Emute-Lab-Instruments/Myriad/py/cases.png

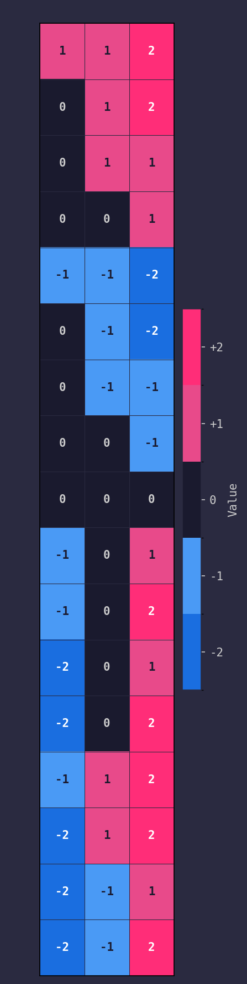
py/cases.png
