Emute-Lab-Instruments/Myriad/hardware/myriad 0.2 panel.stl

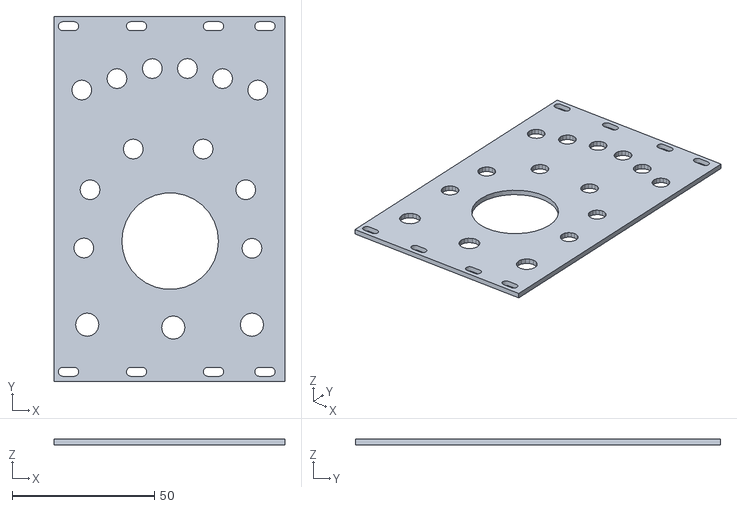
[picture p2: CAD file, 2024-12-16]
hardware/myriad 0.2 panel.stl
81.3 x 128.5 x 2.00
