Emute-Lab-Instruments/Myriad/hardware/panel/myriad2026run/myriad-filled-dxf/myriad-all_layers-filled-pink.dxf

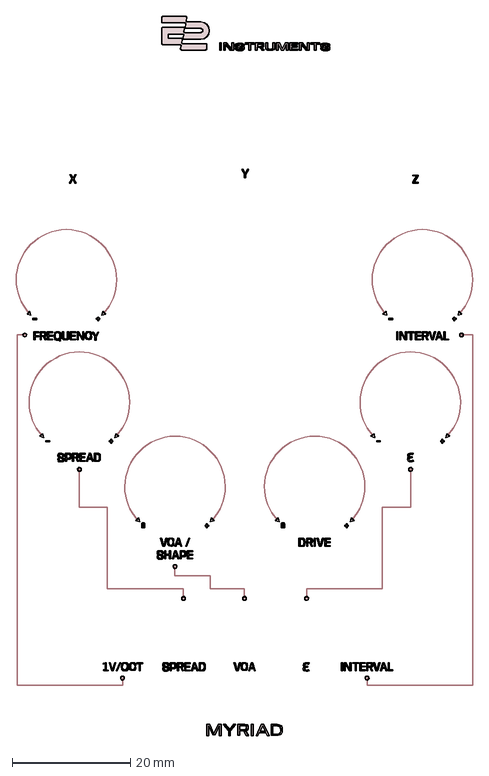
[picture p3: CAD file, 2026-06-30]
hardware/panel/myriad2026run/myriad-filled-dxf/myriad-all_layers-filled-pink.dxf
77.3 x 121.7 mm
