Emute-Lab-Instruments/Myriad/hardware/panel/myriadPanel0_4/myriadPanel0_4.step

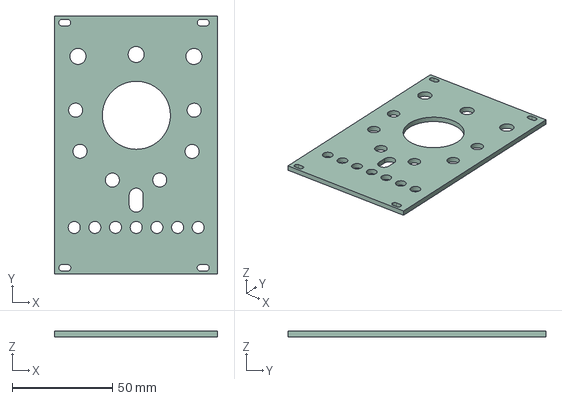
[picture p4: CAD file, 2025-03-19]
hardware/panel/myriadPanel0_4/myriadPanel0_4.step
81.7 x 128.9 x 2.80 mm
