Emute-Lab-Instruments/Myriad/hardware/panel/myriad2026run/myriad-filled-dxf/myriad-all_layers-filled-cnc.dxf

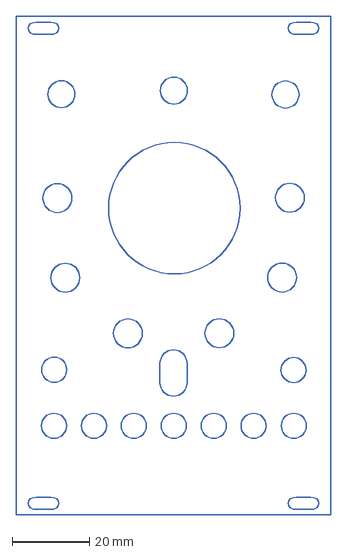
[picture p5: CAD file, 2026-06-30]
hardware/panel/myriad2026run/myriad-filled-dxf/myriad-all_layers-filled-cnc.dxf
81.3 x 128.9 mm
