Emute-Lab-Instruments/Myriad/hardware/spacers.stl

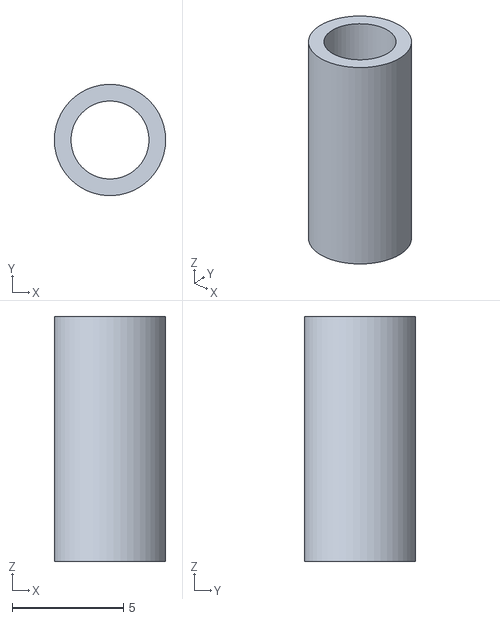
[picture p6: CAD file, 2024-10-05]
hardware/spacers.stl
5.00 x 4.99 x 11.0
