Emute-Lab-Instruments/Myriad/hardware/myriad panel.stl

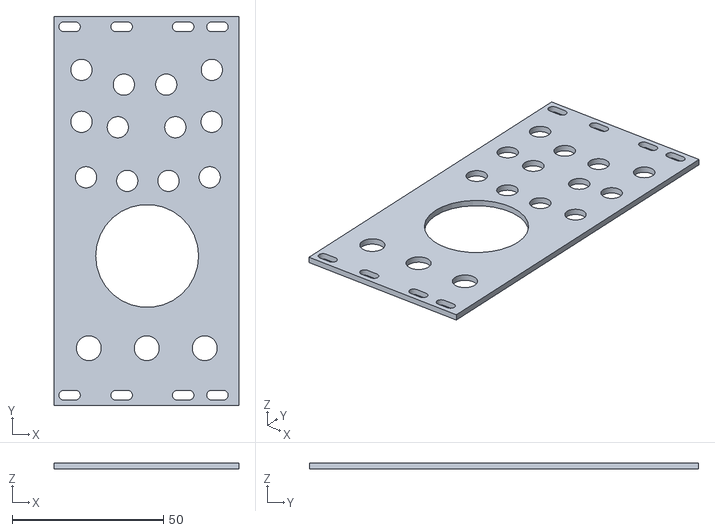
[picture p7: CAD file, 2024-10-05]
hardware/myriad panel.stl
61.0 x 128.5 x 2.00
