Emute-Lab-Instruments/Myriad/hardware/panel/myriad2026run/myriad-filled-dxf/myriad-all_layers-filled-white.dxf

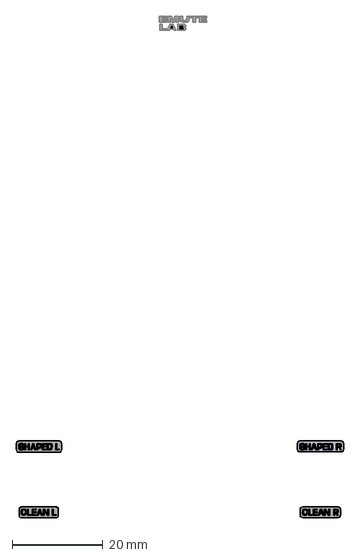
[picture p8: CAD file, 2026-06-30]
hardware/panel/myriad2026run/myriad-filled-dxf/myriad-all_layers-filled-white.dxf
72.0 x 110.3 mm
