Emute-Lab-Instruments/Myriad/hardware/spacers.scad

$fn=50;
difference() {
    cylinder(11, d=5);
    cylinder(13, d=3.5);
    
}
