Emute-Lab-Instruments/Myriad/(list of files, cad)

Other CAD files:
hardware/panel/myriad2026run/fromPosin/myriad-all_layers.dwg
hardware/panel/myriad2026run/fromPosin/myriad-all_layers-filled-cnc.dwg
