Emute-Lab-Instruments/Myriad/calibration/py/adc_calibration.png

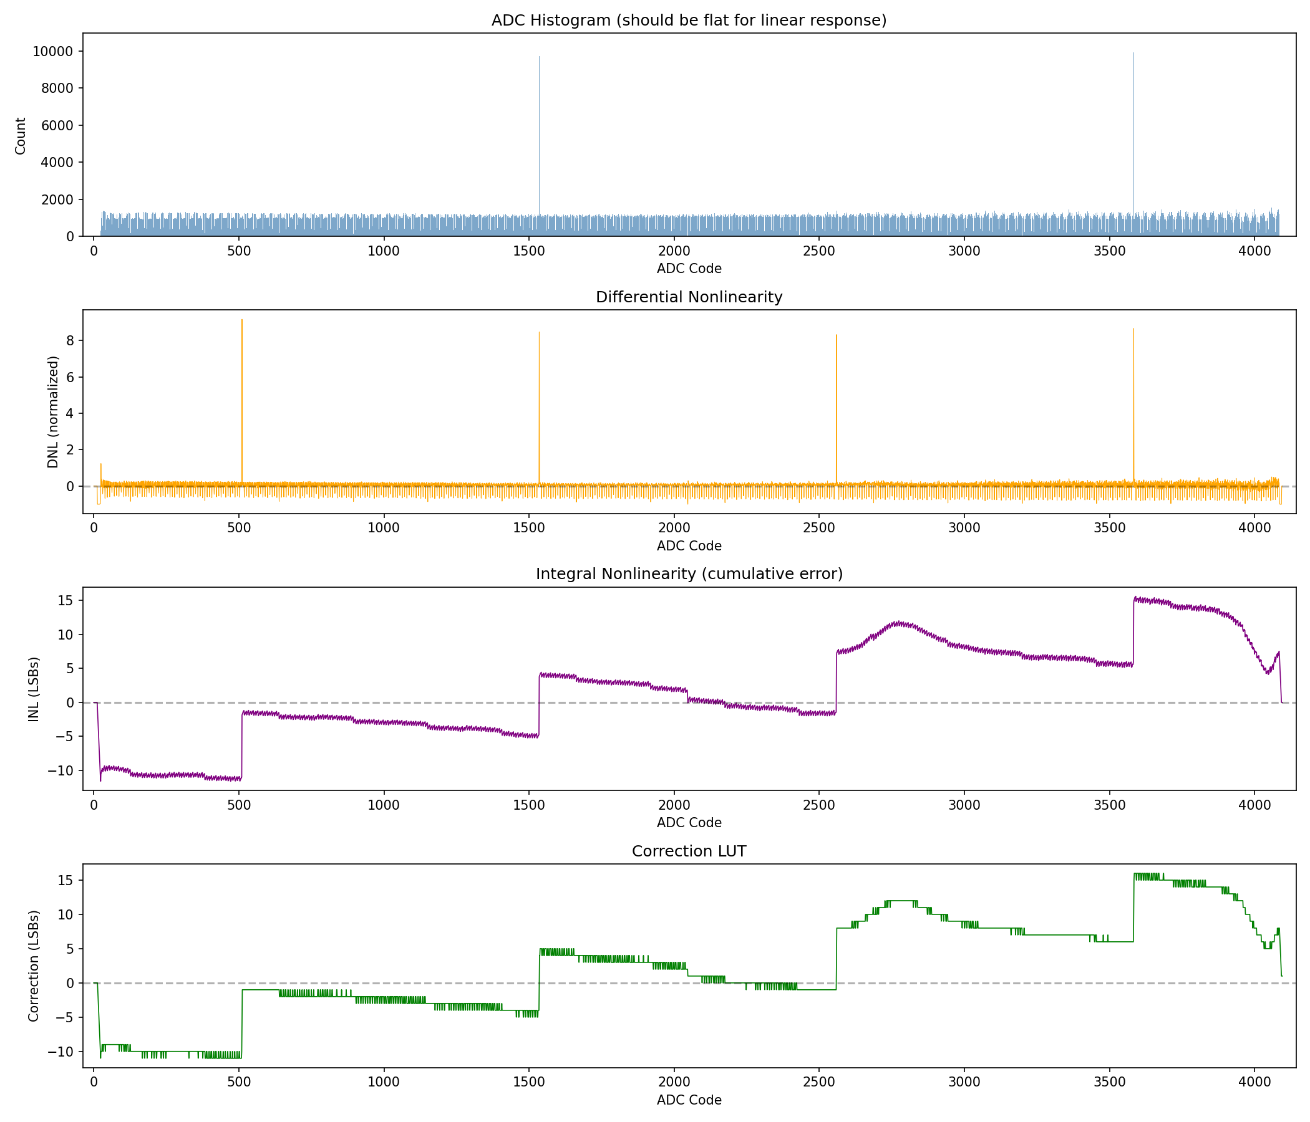
calibration/py/adc_calibration.png
