Emute-Lab-Instruments/Myriad/(threads)

Thread 6 (2025-06-06):

alternatave dma config

chriskiefer, 2025-06-06:
use double buffered ping-pong/chaining?

chriskiefer, 2025-06-06:
actually this doesn't work with interrupts

Closed 2025-06-06.

Thread 17 (2025-07-15):

reset sigma delta oscillators on switch

chriskiefer, 2025-07-15:

Closed 2025-07-18.

Thread 18 (2025-07-18):

zero screen RAM on startup

chriskiefer, 2025-07-18:
prevent noise showing when you switch on the module

Closed 2025-07-23.

Thread 23 (2025-07-23):

encoders should ignore  change when pressed and shortly after

chriskiefer, 2025-07-23:

Thread 26 (2025-07-26):

strategy for saving state

chriskiefer, 2025-07-26:
should we save state?  i.e. restore the last combo of oscillator models on startup?

Writing on every change will quickly eat thru the 100k rewrites spec of the flash memory.  Options:

[1] Run a function every minute (?), and save if there have been changes.  So might make 60 saves per hour,  wears out memory after (1700 hours) 70ish days of use

[2] Manual save - maybe hold down an encoder switch, or add an admin menu. left encoder is unused in oscillator mode

[3] don't save, it's quick anyway to dial in combo, and saving adds complexity. Does it really matter to boot up in previous combo?  Actually maybe yes if you have e.g. a live setup that needs to work the same every time?

stevemuio, 2025-07-26:
> should we save state? i.e. restore the last combo of oscillator models on startup?
>

yes saving is useful as you point out at the end.   maybe a number of presets?

> Writing on every change will quickly eat thru the 100k rewrites spec of the flash memory.

Using a file system like littleFS can help I think it manages wear rather than rewriting over the same sector each time. It also makes reading and writing multiple settings easier into smaller files.

Options:
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

chriskiefer, 2025-07-27:
good to know that littlefs does wear levelling. in which case it will take a long time to use 14mb of flash for just a few bytes of data.  TODO:  look into littlefs config to maximise wear levelling.

Thread 43 (2025-08-31):

concurreny issue when switching screen mode

chriskiefer, 2025-08-31:

Thread 44 (2025-08-31):

sometimes osc model 8 goes silent or glitches when you switch

chriskiefer, 2025-08-31:

chriskiefer, 2025-08-31:
this model isn't actually that interesting, just changes pitch

Closed 2025-08-31.

Thread 45 (2025-08-31):

glitch switching from noise model to p100, but doesn't happen if switching from 8 expdec

chriskiefer, 2025-08-31:

chriskiefer, 2025-08-31:
fixed, loopLength didn't match the length of the template so it was reading old fixed values from buffer memory

Closed 2025-08-31.

Thread 46 (2025-09-01):

modulation should reset when switching metamods

chriskiefer, 2025-09-01:

chriskiefer, 2025-09-03:
actually this probably wasn't a bug - could have been hearing something else as the modulation should reset

Closed 2025-09-03.

Thread 47 (2025-09-01):

make sure pitch doesn't go below 20hz - can crash osc model

chriskiefer, 2025-09-01:
