Emute-Lab-Instruments/Myriad/hardware/myriad_print.pdf

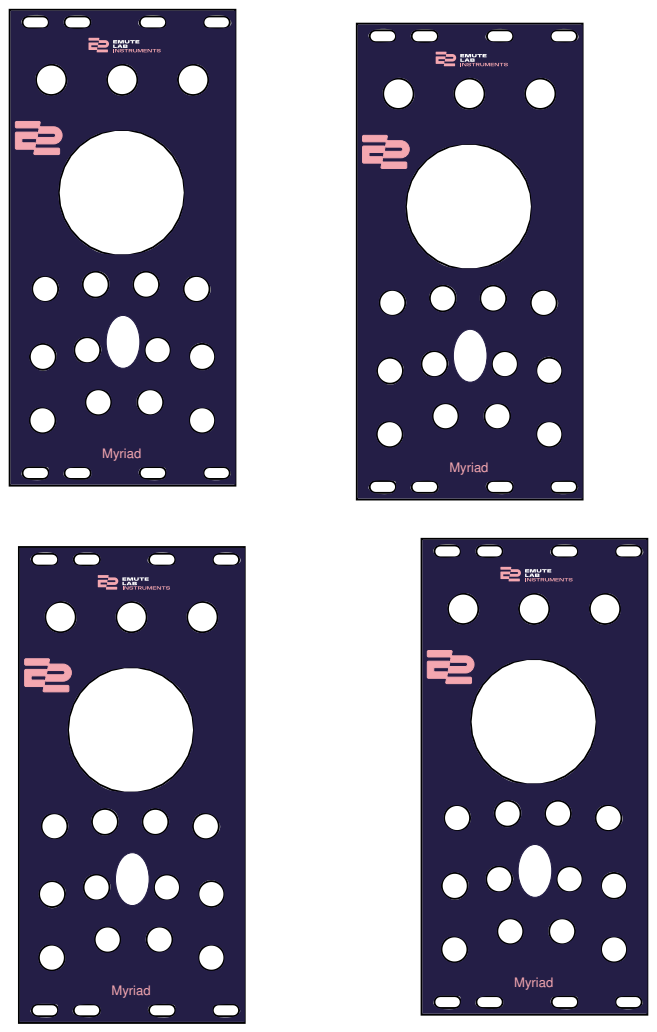
[picture p10: page 1]
Myriad
