Emute-Lab-Instruments/Myriad/arduino_libmyriad/myriad_pins.h

#pragma once

#define LED_PIN 22
#define CALIBRATE_BUTTON 0 //connected to myriad A


//core A1
#define OSC7_PIN 5 //L
#define OSC8_PIN 6 //L
#define OSC9_PIN 10 //R

//core B0
#define OSC1_PIN 2 //R
#define OSC2_PIN 16 //L
#define OSC3_PIN 5 //R
#define OSC1_PIN_DUP 7  //not used

//core B1
#define OSC4_PIN 6 //R
#define OSC5_PIN 17 //L
#define OSC6_PIN 8 // L
