Emute-Lab-Instruments/Myriad/pins.h

#pragma once

#define LED_PIN 22
#define OSC1_PIN 7
#define OSC2_PIN 8
#define OSC3_PIN 9
#define OSC4_PIN 10
#define OSC5_PIN 11
#define OSC6_PIN 12
