Emute-Lab-Instruments/Myriad/Myriad_B/Myriad_B.ino

#include "myriad_pins.h"
#include "hardware/sync.h"
#include "pios/pio_sq.h"
#include "pios/pio_pulse.h"
#include "pios/pio_expdec.h"
#include "pios/pio_bitbybit.h"
#include "smBitStreamOsc.h"
#include "myriad_messages.h"
#include "SLIP.h"
#include "oscillatorModels.hpp"
#include "bitstreams.hpp"

#include <memory>
#include "octaves.hpp"
#include "clockfreq.h"
#include "streamMessaging.hpp"
#include "fixedpoint.hpp"
#include "perf.hpp"

using namespace FixedPoint;
using WvlenFPType = Fixed<20,11>;

#define RUNCORE0_OSCS
#define RUNCORE1_OSCS

bool core1_separate_stack = true;
#define CORE0_FAST_MEM __scratch_x("myriad")
#define CORE1_FAST_MEM __scratch_y("myriad")

#define DMACH_CORE0_OSC0 0
#define DMACH_CORE0_OSC1 2
#define DMACH_CORE0_OSC2 4
#define DMACH_CORE1_OSC0 1
#define DMACH_CORE1_OSC1 3
#define DMACH_CORE1_OSC2 5
#define DMACH_SERIAL_RX_A 6
#define DMACH_SERIAL_RX_B 7


// oscModelPtr FAST_MEM currOscModelBank0;
// oscModelPtr FAST_MEM currOscModelBank1;

std::array<oscModelPtr, 3> FAST_MEM currOscModels0;
std::array<oscModelPtr, 3> FAST_MEM currOscModels1;
std::array<std::array<oscModelPtr, 3>, N_OSCILLATOR_MODELS> allOscModels0;
std::array<std::array<oscModelPtr, 3>, N_OSCILLATOR_MODELS> allOscModels1;

static sawOscillatorModel           sawModels0[3],          sawModels1[3];
static expPulseSDOscillatorModel    expPulseSDModels0[3],   expPulseSDModels1[3];
static sharkTeethSDOscillatorModel  sharkTeethSDModels0[3], sharkTeethSDModels1[3];
static pulsePWOscillatorModel       pulsePWModels0[3],      pulsePWModels1[3];
static expPulse2SDOscillatorModel   expPulse2SDModels0[3],  expPulse2SDModels1[3];
static triOscillatorModel           triModels0[3],          triModels1[3];
static triTeethOscillatorModel      triTeethModels0[3],     triTeethModels1[3];
static parasineSDOscillatorModel    parasineSDModels0[3],   parasineSDModels1[3];
static formantSDOscillatorModel     formantSDModels0[3],    formantSDModels1[3];
static bellSDOscillatorModel        bellSDModels0[3],       bellSDModels1[3];
static noiseOscillatorModelSD       noiseSDModels0[3],      noiseSDModels1[3];
static whiteNoiseOscillatorModel    whiteNoiseModels0[3],   whiteNoiseModels1[3];
static silentOscillatorModel        silentModels0[3],       silentModels1[3];

static spin_lock_t FAST_MEM *calcOscsSpinlock0;
static spin_lock_t FAST_MEM *calcOscsSpinlock1;



volatile bool FAST_MEM waitingForFirstFrequency0=true;
volatile bool FAST_MEM oscsStartedAfterFirstFrequency0=false;
volatile bool FAST_MEM waitingForFirstFrequency1=true;
volatile bool FAST_MEM oscsStartedAfterFirstFrequency1=false;

// Track current bank types to prevent redundant changes
volatile size_t FAST_MEM currentBank0Type = 0;
volatile size_t FAST_MEM currentBank1Type = 0;
volatile size_t FAST_MEM requestedBank0 = 0;
volatile size_t FAST_MEM requestedBank1 = 0;

enum bankChangeStages { BANK_IDLE, BANK_FADING };
bankChangeStages FAST_MEM bankChangeStage0 = BANK_IDLE;
bankChangeStages FAST_MEM bankChangeStage1 = BANK_IDLE;
volatile bool FAST_MEM changeBankFlag0 = false;
volatile bool FAST_MEM changeBankFlag1 = false;



DEFINE_TIMING_SWAPBUFFERS(0, __scratch_x("swap"))
DEFINE_TIMING_SWAPBUFFERS(1, __scratch_x("swap"))
DEFINE_TIMING_SWAPBUFFERS(2, __scratch_x("swap"))
DEFINE_TIMING_SWAPBUFFERS(3, __scratch_y("swap"))
DEFINE_TIMING_SWAPBUFFERS(4, __scratch_y("swap"))
DEFINE_TIMING_SWAPBUFFERS(5, __scratch_y("swap"))


uint32_t CORE0_FAST_MEM smOsc0_dma_chan;
uint32_t CORE0_FAST_MEM smOsc0_dma_chan_bit;

uint32_t CORE0_FAST_MEM smOsc1_dma_chan;
uint32_t CORE0_FAST_MEM smOsc1_dma_chan_bit;

uint32_t CORE0_FAST_MEM smOsc2_dma_chan;
uint32_t CORE0_FAST_MEM smOsc2_dma_chan_bit;

bool FAST_MEM bufSent0 = false;
bool FAST_MEM bufSent1 = false;
bool FAST_MEM bufSent2 = false;
bool FAST_MEM bufSent3 = false;
bool FAST_MEM bufSent4 = false;
bool FAST_MEM bufSent5 = false;



/////////////////////////////////   IRQ 000000000000000000000000000000000000
void __isr dma_irh() {
  //TEST
  // Serial.println("dma");
  uint32_t triggered_channels = dma_hw->ints0;
  if (triggered_channels & smOsc0_dma_chan_bit) {
    dma_hw->ints0 = smOsc0_dma_chan_bit;  
    dma_hw->ch[smOsc0_dma_chan].al3_read_addr_trig = nextTimingBuffer0;
    bufSent0 = true;
  }
  else
  if (triggered_channels & smOsc1_dma_chan_bit) {
    dma_hw->ints0 = smOsc1_dma_chan_bit;
    dma_hw->ch[smOsc1_dma_chan].al3_read_addr_trig = nextTimingBuffer1;
    bufSent1 = true;
  }
  else
  if (triggered_channels & smOsc2_dma_chan_bit) {
    dma_hw->ints0 = smOsc2_dma_chan_bit;
    dma_hw->ch[smOsc2_dma_chan].al3_read_addr_trig = nextTimingBuffer2;
    bufSent2 = true;
  }
}
smBitStreamOsc FAST_MEM smOsc0;
smBitStreamOsc FAST_MEM smOsc1;
smBitStreamOsc FAST_MEM smOsc2;


uint32_t CORE1_FAST_MEM smOsc3_dma_chan;
uint32_t CORE1_FAST_MEM smOsc3_dma_chan_bit;
uint32_t CORE1_FAST_MEM smOsc4_dma_chan;
uint32_t CORE1_FAST_MEM smOsc4_dma_chan_bit;
uint32_t CORE1_FAST_MEM smOsc5_dma_chan;
uint32_t CORE1_FAST_MEM smOsc5_dma_chan_bit;

bool FAST_MEM oscsRunning0 = false;
bool FAST_MEM oscsRunning1 = false;

Fixed<16,16> FAST_MEM epsilon_fixed(0);

PERF_DECLARE(SERIALRX);
PERF_DECLARE(CALCOSCS0);
PERF_DECLARE(CALCOSCS1);




/////////////////////////////////   IRQ 11111111111111111111111111111
void __not_in_flash_func(dma_irh1)() {
  uint32_t triggered_channels = dma_hw->ints1;
  if (triggered_channels & smOsc3_dma_chan_bit) {
    dma_hw->ints1 = smOsc3_dma_chan_bit;  
    dma_hw->ch[smOsc3_dma_chan].al3_read_addr_trig = nextTimingBuffer3;
    bufSent3 = true;
  }
  else
  if (triggered_channels & smOsc4_dma_chan_bit) {
  //   // Channel 0 triggered, handle it
    dma_hw->ints1 = smOsc4_dma_chan_bit;
    dma_hw->ch[smOsc4_dma_chan].al3_read_addr_trig = nextTimingBuffer4;
    bufSent4 = true;
  }
  else
  if (triggered_channels & smOsc5_dma_chan_bit) {
    dma_hw->ints1 = smOsc5_dma_chan_bit;
    dma_hw->ch[smOsc5_dma_chan].al3_read_addr_trig = nextTimingBuffer5;
    bufSent5 = true;
  }
}


smBitStreamOsc FAST_MEM smOsc3;
smBitStreamOsc FAST_MEM smOsc4;
smBitStreamOsc FAST_MEM smOsc5;



enum SPISTATES {WAITFOREND, ENDORBYTES, READBYTES};
static SPISTATES  __not_in_flash("mydata") spiState = SPISTATES::WAITFOREND;
static int __not_in_flash("mydata") spiIdx=0;

int oscBankChange=-1;

void restart_sm(PIO pio, uint sm) {
  // Reset the state machine program counter to zero
  // pio_sm_exec(pio, sm, pio_encode_jmp(0));
  
  // Alternatively, you can use the RESTART flag directly:
  pio->ctrl = (1u << (PIO_CTRL_SM_RESTART_LSB + sm));
}

void assignOscModels0(size_t modelIdx) {
  for (size_t i = 0; i < currOscModels0.size(); i++) {
    currOscModels0[i] = allOscModels0[modelIdx][i];
  }
}
void assignOscModels1(size_t modelIdx) {
  for (size_t i = 0; i < currOscModels1.size(); i++) {
    currOscModels1[i] = allOscModels1[modelIdx][i];
  }
}

void __force_inline calculateOscBuffers0() {
  if ((currOscModels0[0]->updateBufferInSyncWithDMA && bufSent0) || (!currOscModels0[0]->updateBufferInSyncWithDMA && currOscModels0[0]->newFreq)) {
    currOscModels0[0]->newFreq = false;
    updateTimingBuffer(nextTimingBuffer0, timing_swapbuffer_0_A, timing_swapbuffer_0_B, currOscModels0[0]);
    bufSent0 = false;
  }
  if ((currOscModels0[1]->updateBufferInSyncWithDMA && bufSent1) || (!currOscModels0[1]->updateBufferInSyncWithDMA && currOscModels0[1]->newFreq)) {
    currOscModels0[1]->newFreq = false;
    updateTimingBuffer(nextTimingBuffer1, timing_swapbuffer_1_A, timing_swapbuffer_1_B, currOscModels0[1]);
    bufSent1 = false;
  }
  if ((currOscModels0[2]->updateBufferInSyncWithDMA && bufSent2) || (!currOscModels0[2]->updateBufferInSyncWithDMA && currOscModels0[2]->newFreq)) {
    currOscModels0[2]->newFreq = false;
    updateTimingBuffer(nextTimingBuffer2, timing_swapbuffer_2_A, timing_swapbuffer_2_B, currOscModels0[2]);
    bufSent2 = false;
  }
}

void __force_inline calculateOscBuffers1() {
  if ((currOscModels1[0]->updateBufferInSyncWithDMA && bufSent3) || (!currOscModels1[0]->updateBufferInSyncWithDMA && currOscModels1[0]->newFreq)) {
    currOscModels1[0]->newFreq = false;
    updateTimingBuffer(nextTimingBuffer3, timing_swapbuffer_3_A, timing_swapbuffer_3_B, currOscModels1[0]);
    bufSent3 = false;
  }
  if ((currOscModels1[1]->updateBufferInSyncWithDMA && bufSent4) || (!currOscModels1[1]->updateBufferInSyncWithDMA && currOscModels1[1]->newFreq)) {
    currOscModels1[1]->newFreq = false;
    updateTimingBuffer(nextTimingBuffer4, timing_swapbuffer_4_A, timing_swapbuffer_4_B, currOscModels1[1]);
    bufSent4 = false;
  }
  if ((currOscModels1[2]->updateBufferInSyncWithDMA && bufSent5) || (!currOscModels1[2]->updateBufferInSyncWithDMA && currOscModels1[2]->newFreq)) {
    currOscModels1[2]->newFreq = false;
    updateTimingBuffer(nextTimingBuffer5, timing_swapbuffer_5_A, timing_swapbuffer_5_B, currOscModels1[2]);
    bufSent5 = false;
  }
}


WvlenFPType FAST_MEM detuneFixed(0);
Q16_16 FAST_MEM metaModWavelenMul3(1);
Q16_16 FAST_MEM metaModWavelenMul4(1);
Q16_16 FAST_MEM metaModWavelenMul5(1);
Q16_16 FAST_MEM metaModWavelenMul6(1);
Q16_16 FAST_MEM metaModWavelenMul7(1);
Q16_16 FAST_MEM metaModWavelenMul8(1);

size_t FAST_MEM octaveIdx = 9;

bool FAST_MEM newFrequenciesReady0 = false;
bool FAST_MEM newFrequenciesReady1 = false;

// float new_wavelen0 = 10000;
WvlenFPType new_wavelen2_fixed;


// static uint8_t __scratch_x("mydata") slipBuffer[64];
bool FAST_MEM newCtrlReady = false;


void startOscBankA() {

  uint programOffset = currOscModels0[0]->loadProg(pio0);


  pio_sm_config baseConfig = currOscModels0[0]->getBaseConfig(programOffset);
  const size_t modelClockDiv = currOscModels0[0]->getClockDiv();

  smOsc0_dma_chan = smOsc0.init(pio0, 0, OSC1_PIN, programOffset, baseConfig, nextTimingBuffer0, dma_irh, modelClockDiv, currOscModels0[0]->loopLength, DMA_IRQ_0, DMACH_CORE0_OSC0);
  if (smOsc0_dma_chan < 0) {
    Serial.println("dma chan allocation error");
  }
  smOsc0_dma_chan_bit = 1u << smOsc0_dma_chan;
  smOsc0.go();

  smOsc1_dma_chan = smOsc1.init(pio0, 1, OSC2_PIN, programOffset, baseConfig, nextTimingBuffer1, dma_irh, modelClockDiv, currOscModels0[1]->loopLength, DMA_IRQ_0,DMACH_CORE0_OSC1);
  smOsc1_dma_chan_bit = 1u << smOsc1_dma_chan;
  smOsc1.go();

  smOsc2_dma_chan = smOsc2.init(pio0, 2, OSC3_PIN, programOffset, baseConfig, nextTimingBuffer2, dma_irh, modelClockDiv, currOscModels0[2]->loopLength, DMA_IRQ_0, DMACH_CORE0_OSC2);
  smOsc2_dma_chan_bit = 1u << smOsc2_dma_chan;
  smOsc2.go();

  oscsRunning0 = true;
}

void stopOscBankA() {

  oscsRunning0 = false;

  smOsc0.stop();
  smOsc1.stop();
  smOsc2.stop();

  currOscModels0[0]->unloadProg(pio0);

  // Clear the buffers explicitly
  memset(timing_swapbuffer_0_A, 0, sizeof(timing_swapbuffer_0_A));
  memset(timing_swapbuffer_0_B, 0, sizeof(timing_swapbuffer_0_B));
  memset(timing_swapbuffer_1_A, 0, sizeof(timing_swapbuffer_1_A));
  memset(timing_swapbuffer_1_B, 0, sizeof(timing_swapbuffer_1_B));
  memset(timing_swapbuffer_2_A, 0, sizeof(timing_swapbuffer_2_A));
  memset(timing_swapbuffer_2_B, 0, sizeof(timing_swapbuffer_2_B));

  // Reset buffer pointers to A buffers
  nextTimingBuffer0 = (io_rw_32)timing_swapbuffer_0_A;
  nextTimingBuffer1 = (io_rw_32)timing_swapbuffer_1_A;
  nextTimingBuffer2 = (io_rw_32)timing_swapbuffer_2_A;

  bufSent0 = false;
  bufSent1 = false;
  bufSent2 = false;

}

void startOscBankB() {


  // Don't clear entire PIO - this would destroy the RX program
  // The oscillator loadProg() will add its program without clearing others
  // pio_clear_instruction_memory(pio1);

  uint programOffset = currOscModels1[0]->loadProg(pio1);
  pio_sm_config baseConfig = currOscModels1[0]->getBaseConfig(programOffset);

  const size_t modelClockDiv = currOscModels1[0]->getClockDiv();

  // Monitor PIO program placement
  // Check how much PIO memory is used (32 instructions max)

  smOsc3_dma_chan = smOsc3.init(pio1, 0, OSC4_PIN, programOffset, baseConfig, nextTimingBuffer3, dma_irh1, modelClockDiv, currOscModels1[0]->loopLength, DMA_IRQ_1, DMACH_CORE1_OSC0);
  smOsc3_dma_chan_bit = 1u << smOsc3_dma_chan;
  smOsc3.go();

  smOsc4_dma_chan = smOsc4.init(pio1, 1, OSC5_PIN, programOffset, baseConfig, nextTimingBuffer4, dma_irh1, modelClockDiv, currOscModels1[1]->loopLength, DMA_IRQ_1, DMACH_CORE1_OSC1);
  smOsc4_dma_chan_bit = 1u << smOsc4_dma_chan;
  smOsc4.go();

  smOsc5_dma_chan = smOsc5.init(pio1, 2, OSC6_PIN, programOffset, baseConfig, nextTimingBuffer5, dma_irh1, modelClockDiv, currOscModels1[2]->loopLength, DMA_IRQ_1, DMACH_CORE1_OSC2);
  smOsc5_dma_chan_bit = 1u << smOsc5_dma_chan;
  smOsc5.go();
  oscsRunning1 = true;


}

void stopOscBankB() {
  oscsRunning1 = false;

  smOsc3.stop();
  smOsc4.stop();
  smOsc5.stop();

  currOscModels1[0]->unloadProg(pio1);


  memset(timing_swapbuffer_3_A, 0, sizeof(timing_swapbuffer_3_A));
  memset(timing_swapbuffer_3_B, 0, sizeof(timing_swapbuffer_3_B));
  memset(timing_swapbuffer_4_A, 0, sizeof(timing_swapbuffer_4_A));
  memset(timing_swapbuffer_4_B, 0, sizeof(timing_swapbuffer_4_B));
  memset(timing_swapbuffer_5_A, 0, sizeof(timing_swapbuffer_5_A));
  memset(timing_swapbuffer_5_B, 0, sizeof(timing_swapbuffer_5_B));
  
  // Reset buffer pointers to A buffers
  nextTimingBuffer3 = (io_rw_32)timing_swapbuffer_3_A;
  nextTimingBuffer4 = (io_rw_32)timing_swapbuffer_4_A;
  nextTimingBuffer5 = (io_rw_32)timing_swapbuffer_5_A;  

  bufSent3 = false;
  bufSent4 = false;
  bufSent5 = false;

}

__force_inline void __not_in_flash_func(processSerialMessage)(streamMessaging::msgpacket &msg) {
  switch(msg.msgType) {
    case streamMessaging::messageTypes::WAVELEN0:
    {
      
      // uint32_t save = spin_lock_blocking(calcOscsSpinlock0);  
      // new_wavelen0 = msg.value.floatValue;
      WvlenFPType new_wavelen0_fixed = WvlenFPType::from_raw(msg.value.intValue);
      new_wavelen2_fixed = new_wavelen0_fixed - detuneFixed - detuneFixed;
      newFrequenciesReady0 = true;
      newFrequenciesReady1 = true;
      waitingForFirstFrequency0 = false;
      waitingForFirstFrequency1 = false;
      break;
    }
    case streamMessaging::messageTypes::DETUNE:
    {
      detuneFixed = WvlenFPType::from_raw(msg.value.intValue);
      break;
    }     
    case streamMessaging::messageTypes::METAMOD3:
    {
      metaModWavelenMul3 = Q16_16::from_raw(msg.value.intValue);
      break;
    }
    case streamMessaging::messageTypes::METAMOD4:
    {
      metaModWavelenMul4 = Q16_16::from_raw(msg.value.intValue);
      break;
    }
    case streamMessaging::messageTypes::METAMOD5:
    {
      metaModWavelenMul5 = Q16_16::from_raw(msg.value.intValue);
      break;
    }
    case streamMessaging::messageTypes::METAMOD6:
    {
      uint32_t save1 = spin_lock_blocking(calcOscsSpinlock1);  
      metaModWavelenMul6 = Q16_16::from_raw(msg.value.intValue);
      spin_unlock(calcOscsSpinlock1, save1);
      break;
    }
    case streamMessaging::messageTypes::METAMOD7:
    {
      uint32_t save1 = spin_lock_blocking(calcOscsSpinlock1);  
      metaModWavelenMul7 = Q16_16::from_raw(msg.value.intValue);
      spin_unlock(calcOscsSpinlock1, save1);
      break;
    }
    case streamMessaging::messageTypes::METAMOD8:
    {
      uint32_t save1 = spin_lock_blocking(calcOscsSpinlock1);  
      metaModWavelenMul8 = Q16_16::from_raw(msg.value.intValue);
      spin_unlock(calcOscsSpinlock1, save1);
      break;
    }
    case streamMessaging::messageTypes::OCTSPREAD:
    {
      octaveIdx = msg.value.uintValue;
      if (octaveIdx > numOctaveShifts-1) octaveIdx = numOctaveShifts-1;
      currentOctaveShifts = (int8_t *)octaveTableShift[octaveIdx];
      break;
    }
    case streamMessaging::messageTypes::CTRL0:
    {
      epsilon_fixed = Q16_16::from_raw(msg.value.intValue);
      newCtrlReady = true;

      currOscModels0[0]->ctrl(epsilon_fixed);
      currOscModels0[1]->ctrl(epsilon_fixed);
      currOscModels0[2]->ctrl(epsilon_fixed);

      break;
    }
    case streamMessaging::messageTypes::BANK0:
    {
      size_t bank = msg.value.uintValue;
      size_t targetBank0 = changeBankFlag0 ? requestedBank0 : currentBank0Type;
      // Serial.printf("bank0 change %d\n", bank);
      if (bank != targetBank0) {
        requestedBank0 = bank;
        changeBankFlag0 = true;
      }
    }
    break;
    case streamMessaging::messageTypes::BANK1:
    {
      size_t bank = msg.value.uintValue;
      uint32_t save = spin_lock_blocking(calcOscsSpinlock1);
      size_t targetBank1 = changeBankFlag1 ? requestedBank1 : currentBank1Type;
      if (bank != targetBank1) {
        requestedBank1 = bank;
        changeBankFlag1 = true;
      }
      spin_unlock(calcOscsSpinlock1, save);
    }
    break;
    default:
      break;
  }
}  



const size_t oscStartDelay = 200;

void setup() {
  //show on board LED
  pinMode(LED_PIN, OUTPUT);
  digitalWrite(LED_PIN, 0);

  calcOscsSpinlock0 = spin_lock_init(spin_lock_claim_unused(true));

  for (size_t i = 0; i < 3; i++) {
    allOscModels0[0][i]  = &sawModels0[i];
    allOscModels0[1][i]  = &expPulseSDModels0[i];
    allOscModels0[2][i]  = &sharkTeethSDModels0[i];
    allOscModels0[3][i]  = &pulsePWModels0[i];
    allOscModels0[4][i]  = &expPulse2SDModels0[i];
    allOscModels0[5][i]  = &triModels0[i];
    allOscModels0[6][i]  = &triTeethModels0[i];
    allOscModels0[7][i]  = &parasineSDModels0[i];
    allOscModels0[8][i]  = &formantSDModels0[i];
    allOscModels0[9][i]  = &bellSDModels0[i];
    allOscModels0[10][i] = &noiseSDModels0[i];
    allOscModels0[11][i] = &whiteNoiseModels0[i];
    allOscModels0[12][i] = &silentModels0[i];
  }
  assignOscModels0(0);


  Serial.begin();
  // while(!Serial) {}
  pinMode(22,OUTPUT);
  streamMessaging::setupRX(pio0, 22, 12, DMACH_SERIAL_RX_A, DMACH_SERIAL_RX_B);
}

size_t counter=0;
size_t checkevery=20000;
size_t errorCount=0;
size_t totalMessagesReceived=0;

size_t serialts=0;

void __not_in_flash_func(loop)() {
  digitalWrite(22,0);

  streamMessaging::msgpacket* msg;
  streamMessaging::RxStatus status = streamMessaging::receiveWithDMA(&msg);

  if (status != streamMessaging::RxStatus::NO_MESSAGE) {
      if (status == streamMessaging::RxStatus::MESSAGE_OK) {
          totalMessagesReceived++;
          digitalWrite(22,1);
          PERF_BEGIN(SERIALRX);
          processSerialMessage(*msg);
          PERF_END(SERIALRX);
      } else {
          errorCount++;
      }
      // if (counter++ == checkevery) {
      //     Serial.printf("%d messages received, %d errors, %d total\n", checkevery, errorCount,totalMessagesReceived);
      //     counter=0;
      //     errorCount=0;
      // }
  }
  if (waitingForFirstFrequency0 == false && oscsStartedAfterFirstFrequency0 == false) {

    startOscBankA();
    oscsStartedAfterFirstFrequency0 = true;
  }
  if (oscsRunning0) {
    if (newFrequenciesReady0) {
      WvlenFPType new_wavelen3_fixed = (new_wavelen2_fixed - detuneFixed);
      WvlenFPType new_wavelen4_fixed = (new_wavelen3_fixed - detuneFixed);
      WvlenFPType new_wavelen5_fixed = (new_wavelen4_fixed - detuneFixed);

      new_wavelen3_fixed = new_wavelen3_fixed.mulWith(metaModWavelenMul3);
      new_wavelen4_fixed = new_wavelen4_fixed.mulWith(metaModWavelenMul4);
      new_wavelen5_fixed = new_wavelen5_fixed.mulWith(metaModWavelenMul5);

      // guard against negative wavelen (heavy detune at low pitch) wrapping to huge size_t
      if (new_wavelen3_fixed < minWavelenFP) new_wavelen3_fixed = minWavelenFP;
      if (new_wavelen4_fixed < minWavelenFP) new_wavelen4_fixed = minWavelenFP;
      if (new_wavelen5_fixed < minWavelenFP) new_wavelen5_fixed = minWavelenFP;

      new_wavelen3_fixed = currentOctaveShifts[1] > 0 ? new_wavelen3_fixed >> currentOctaveShifts[1] : new_wavelen3_fixed.safeShiftLeft(-currentOctaveShifts[1]);
      new_wavelen4_fixed = currentOctaveShifts[1] > 0 ? new_wavelen4_fixed >> currentOctaveShifts[1] : new_wavelen4_fixed.safeShiftLeft(-currentOctaveShifts[1]);
      new_wavelen5_fixed = currentOctaveShifts[1] > 0 ? new_wavelen5_fixed >> currentOctaveShifts[1] : new_wavelen5_fixed.safeShiftLeft(-currentOctaveShifts[1]);

      currOscModels0[0]->setWavelen(new_wavelen3_fixed.to_int());
      currOscModels0[1]->setWavelen(new_wavelen4_fixed.to_int());
      currOscModels0[2]->setWavelen(new_wavelen5_fixed.to_int());
      newFrequenciesReady0 = false;
    }
    
    // uint32_t save = spin_lock_blocking(calcOscsSpinlock0);
    PERF_BEGIN(CALCOSCS0);
    calculateOscBuffers0();
    PERF_END(CALCOSCS0);
    // spin_unlock(calcOscsSpinlock0, save);

    if (changeBankFlag0) {
      if (bankChangeStage0 == BANK_IDLE) {
        currOscModels0[0]->startFadeOut();
        currOscModels0[1]->startFadeOut();
        currOscModels0[2]->startFadeOut();
        bankChangeStage0 = BANK_FADING;
      } else if (bankChangeStage0 == BANK_FADING) {
        if (!currOscModels0[0]->isFadingOut()) {
          auto w1 = currOscModels0[0]->getWavelen();
          auto w2 = currOscModels0[1]->getWavelen();
          auto w3 = currOscModels0[2]->getWavelen();

          assignOscModels0(requestedBank0);

          smOsc0.setClockDiv(currOscModels0[0]->getClockDiv());
          smOsc1.setClockDiv(currOscModels0[1]->getClockDiv());
          smOsc2.setClockDiv(currOscModels0[2]->getClockDiv());

          currOscModels0[0]->prepareForFadeIn();
          currOscModels0[1]->prepareForFadeIn();
          currOscModels0[2]->prepareForFadeIn();

          currOscModels0[0]->setWavelen(w1);
          currOscModels0[1]->setWavelen(w2);
          currOscModels0[2]->setWavelen(w3);

          currOscModels0[0]->ctrl(epsilon_fixed);
          currOscModels0[1]->ctrl(epsilon_fixed);
          currOscModels0[2]->ctrl(epsilon_fixed);

          currOscModels0[0]->startFadeIn();
          currOscModels0[1]->startFadeIn();
          currOscModels0[2]->startFadeIn();

          currentBank0Type = requestedBank0;
          bankChangeStage0 = BANK_IDLE;
          changeBankFlag0 = false;
        }
      }
    }
  }

  // auto now = millis();
  // if (now - serialts > 500) {
  //   size_t elapsed = now - serialts;
  //   float msgsPerSec = totalMessagesReceived * 1000.f / elapsed;
  //   Serial.printf("srx: %d us  msgs: %.0f/s  errs: %u  c0: %d us  c1: %d us\n",
  //       PERF_GET_MEAN(SERIALRX),
  //       msgsPerSec,
  //       errorCount,
  //       PERF_GET_MEAN(CALCOSCS0),
  //       PERF_GET_MEAN(CALCOSCS1));
  //   totalMessagesReceived = 0;
  //   errorCount = 0;
  //   serialts=now;
  // }
  // delay(1);
  // __wfi();
}


void setup1() {
  calcOscsSpinlock1 = spin_lock_init(spin_lock_claim_unused(true));

  for (size_t i = 0; i < 3; i++) {
    allOscModels1[0][i]  = &sawModels1[i];
    allOscModels1[1][i]  = &expPulseSDModels1[i];
    allOscModels1[2][i]  = &sharkTeethSDModels1[i];
    allOscModels1[3][i]  = &pulsePWModels1[i];
    allOscModels1[4][i]  = &expPulse2SDModels1[i];
    allOscModels1[5][i]  = &triModels1[i];
    allOscModels1[6][i]  = &triTeethModels1[i];
    allOscModels1[7][i]  = &parasineSDModels1[i];
    allOscModels1[8][i]  = &formantSDModels1[i];
    allOscModels1[9][i]  = &bellSDModels1[i];
    allOscModels1[10][i] = &noiseSDModels1[i];
    allOscModels1[11][i] = &whiteNoiseModels1[i];
    allOscModels1[12][i] = &silentModels1[i];
  }
  assignOscModels1(0);


}

void __not_in_flash_func(loop1)() {
  if (waitingForFirstFrequency1 == false && oscsStartedAfterFirstFrequency1 == false) {
    startOscBankB();
    oscsStartedAfterFirstFrequency1 = true;
  }
  if (oscsRunning1) {
    if (changeBankFlag1) {
      if (bankChangeStage1 == BANK_IDLE) {
        currOscModels1[0]->startFadeOut();
        currOscModels1[1]->startFadeOut();
        currOscModels1[2]->startFadeOut();
        bankChangeStage1 = BANK_FADING;
      } else if (bankChangeStage1 == BANK_FADING) {
        if (!currOscModels1[0]->isFadingOut()) {
          uint32_t save = spin_lock_blocking(calcOscsSpinlock1);
          size_t targetBank = requestedBank1;
          spin_unlock(calcOscsSpinlock1, save);

          auto w1 = currOscModels1[0]->getWavelen();
          auto w2 = currOscModels1[1]->getWavelen();
          auto w3 = currOscModels1[2]->getWavelen();

          assignOscModels1(targetBank);

          smOsc3.setClockDiv(currOscModels1[0]->getClockDiv());
          smOsc4.setClockDiv(currOscModels1[1]->getClockDiv());
          smOsc5.setClockDiv(currOscModels1[2]->getClockDiv());

          currOscModels1[0]->prepareForFadeIn();
          currOscModels1[1]->prepareForFadeIn();
          currOscModels1[2]->prepareForFadeIn();

          currOscModels1[0]->setWavelen(w1);
          currOscModels1[1]->setWavelen(w2);
          currOscModels1[2]->setWavelen(w3);

          currOscModels1[0]->ctrl(epsilon_fixed);
          currOscModels1[1]->ctrl(epsilon_fixed);
          currOscModels1[2]->ctrl(epsilon_fixed);

          currOscModels1[0]->startFadeIn();
          currOscModels1[1]->startFadeIn();
          currOscModels1[2]->startFadeIn();

          save = spin_lock_blocking(calcOscsSpinlock1);
          currentBank1Type = targetBank;
          changeBankFlag1 = false;
          spin_unlock(calcOscsSpinlock1, save);

          bankChangeStage1 = BANK_IDLE;
        }
      }
    }

    if (newCtrlReady) {
      currOscModels1[0]->ctrl(epsilon_fixed);
      currOscModels1[1]->ctrl(epsilon_fixed);
      currOscModels1[2]->ctrl(epsilon_fixed);
      newCtrlReady = false;
    }
    if (newFrequenciesReady1) {
      WvlenFPType new_wavelen6_fixed = (new_wavelen2_fixed - detuneFixed - detuneFixed - detuneFixed - detuneFixed );
      WvlenFPType new_wavelen7_fixed = (new_wavelen6_fixed - detuneFixed);
      WvlenFPType new_wavelen8_fixed = (new_wavelen7_fixed - detuneFixed);

      new_wavelen6_fixed = new_wavelen6_fixed.mulWith(metaModWavelenMul6);
      new_wavelen7_fixed = new_wavelen7_fixed.mulWith(metaModWavelenMul7);
      new_wavelen8_fixed = new_wavelen8_fixed.mulWith(metaModWavelenMul8);

      // guard against negative wavelen (heavy detune at low pitch) wrapping to huge size_t
      if (new_wavelen6_fixed < minWavelenFP) new_wavelen6_fixed = minWavelenFP;
      if (new_wavelen7_fixed < minWavelenFP) new_wavelen7_fixed = minWavelenFP;
      if (new_wavelen8_fixed < minWavelenFP) new_wavelen8_fixed = minWavelenFP;

      new_wavelen6_fixed = currentOctaveShifts[2] > 0 ? new_wavelen6_fixed >> currentOctaveShifts[2] : new_wavelen6_fixed.safeShiftLeft(-currentOctaveShifts[2]);
      new_wavelen7_fixed = currentOctaveShifts[2] > 0 ? new_wavelen7_fixed >> currentOctaveShifts[2] : new_wavelen7_fixed.safeShiftLeft(-currentOctaveShifts[2]);
      new_wavelen8_fixed = currentOctaveShifts[2] > 0 ? new_wavelen8_fixed >> currentOctaveShifts[2] : new_wavelen8_fixed.safeShiftLeft(-currentOctaveShifts[2]);

      currOscModels1[0]->setWavelen(new_wavelen6_fixed.to_int());
      currOscModels1[1]->setWavelen(new_wavelen7_fixed.to_int());
      currOscModels1[2]->setWavelen(new_wavelen8_fixed.to_int());
      newFrequenciesReady1 = false;
    }
    // uint32_t save = spin_lock_blocking(calcOscsSpinlock1);
    PERF_BEGIN(CALCOSCS1);
    calculateOscBuffers1();
    PERF_END(CALCOSCS1);
    // spin_unlock(calcOscsSpinlock1, save);

  }
}
