Emute-Lab-Instruments/Myriad/Myriad_A/ADCCalDefault.hpp

#ifndef ADC_CAL_DEFAULT_HPP
#define ADC_CAL_DEFAULT_HPP

// Your code here

#include <array>


const int calDefaultHisto[4096] = {10,1,1,1,0,0,0,0,3,3,3,5,5,5,5,4,6,8,17,21,57,169,726,271,653,370,285,327,308,317,259,160,292,309,290,273,259,302,335,82,312,318,261,306,339,310,312,130,290,287,340,265,296,266,310,80,293,300,295,256,314,300,310,104,328,236,338,249,312,299,281,51,317,261,315,283,260,277,307,124,292,257,288,284,303,296,282,55,290,239,316,255,327,286,240,126,283,238,305,274,267,278,274,56,315,287,271,238,297,266,287,137,293,259,277,278,267,305,242,61,290,273,283,275,273,283,229,33,310,249,298,238,297,252,289,48,319,236,273,249,334,272,280,107,296,228,300,248,274,243,268,63,282,279,269,240,298,231,332,117,273,197,323,261,330,257,259,55,304,226,314,245,262,269,264,109,342,258,295,270,261,244,288,72,304,223,280,254,297,253,242,116,303,256,299,279,271,295,259,51,300,303,281,238,283,287,293,136,290,247,274,243,292,307,236,71,299,269,283,284,290,264,284,126,310,295,274,275,258,310,263,72,292,247,287,278,289,307,247,133,303,256,297,291,273,304,223,64,291,268,296,293,281,283,270,266,289,303,262,291,286,300,283,61,259,300,260,306,256,286,277,123,310,269,284,262,248,301,278,77,268,314,237,275,267,287,306,134,259,295,284,293,301,249,290,86,278,295,261,284,220,316,264,131,264,270,276,278,299,268,287,54,264,303,318,262,261,294,274,124,278,324,272,270,294,273,269,74,266,275,285,270,307,276,296,105,243,282,295,307,315,269,294,65,267,312,278,246,274,317,279,131,313,260,250,280,268,273,302,53,259,310,286,275,277,259,289,143,270,292,320,236,283,235,322,66,285,264,270,247,310,26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
,24,24,24,25,24,24,25,25,25,25,26,26,26,26,26,26,27,27,27,27,27,28,28,29,29,29,29,30,30,29,30,30,30,31,31,31,31,31,31,30,29,28,27,26,25,24,23,22,21,20,19,18,17,16,15,14,13,12,11,10,9,8,7,6,5,4,3,2,1};
const uint16_t calDefaultADCMin = 0;
const uint16_t calDefaultADCMax = 4095;

#endif // ADC_CAL_DEFAULT_HPP
