Emute-Lab-Instruments/Myriad/arduino_libmyriad/sinetable_fixed.hpp

#ifndef SINETABLE_FIXED_HPP
#define SINETABLE_FIXED_HPP

#pragma once

#include "fixedpoint.hpp"
#include <array>
#include <cmath>

#ifdef PICO_SDK_VERSION_MAJOR
#include "hardware/interp.h"
#endif

namespace FixedPoint {

// ============================================================================
// FIXED-POINT SINE TABLE
// ============================================================================
// Template-based sine lookup table using fixed-point arithmetic
// Designed to match the interface of the float-based sineTable class
// ============================================================================

template<int IntBits, int FracBits, typename StorageT = int32_t>
class SineTableFixed {
public:
    using FixedT = Fixed<IntBits, FracBits, StorageT>;

    static constexpr size_t TABLE_SIZE = 1024;
    static constexpr double TWOPI = 6.283185307179586;
    static constexpr double TWOPI_RCP = 1.0 / TWOPI;

    // Constructor: Pre-calculate sine table at initialization
    SineTableFixed() {
        for (size_t i = 0; i < TABLE_SIZE; ++i) {
            double angle = static_cast<double>(i) / TABLE_SIZE * TWOPI;
            double sine_val = std::sin(angle);
            sine_lut[i] = FixedT(sine_val).raw();
        }

#ifdef PICO_SDK_VERSION_MAJOR
        // Initialize hardware interpolators once
        init_hw_interp();
#endif
    }

#ifdef PICO_SDK_VERSION_MAJOR
    // Initialize hardware interpolators (called once in constructor)
    void init_hw_interp() {
        // Configure interp0 for signed multiplication with shift
        // We'll use it to accelerate the (diff * frac) >> 16 operation
        interp_config cfg = interp_default_config();
        interp_config_set_signed(&cfg, true);     // Signed arithmetic
        interp_config_set_shift(&cfg, 16);        // Right shift by 16 after operation
        interp_config_set_mask(&cfg, 0, 31);      // Use all 32 bits
        interp_set_config(interp0, 0, &cfg);
        interp_set_config(interp0, 1, &cfg);

        // Configure interp1 the same way for dual processing
        interp_set_config(interp1, 0, &cfg);
        interp_set_config(interp1, 1, &cfg);
    }
#endif

    // Fast sine lookup (matches sineTable::fast_sin interface)
    // Range: -2π < x < 4π
    // Uses floor indexing (no interpolation) for maximum speed
    FixedT fast_sin(const FixedT& x) const {
        // Convert x to table index: x * (1/2π) * TABLE_SIZE
        // x.raw() is already scaled by 2^FracBits
        // index = (x.raw() * TABLE_SIZE * TWOPI_RCP) >> FracBits

        constexpr double scale_float = TABLE_SIZE * TWOPI_RCP;  // ~162.97
        constexpr int64_t scale = static_cast<int64_t>(scale_float + 0.5);

        int64_t index_calc = (static_cast<int64_t>(x.raw()) * scale) >> FracBits;
        int32_t index = static_cast<int32_t>(index_calc);

        // Handle wraparound (same logic as float version)
        if (index >= static_cast<int32_t>(TABLE_SIZE)) {
            index -= TABLE_SIZE;
        } else if (index < 0) {
            index += TABLE_SIZE;
        }

        // Bounds check for safety
        if (index < 0 || index >= static_cast<int32_t>(TABLE_SIZE)) {
            index = 0;  // Fallback to zero
        }

        return FixedT::from_raw(sine_lut[index]);
    }

    // Fast cosine lookup (matches sineTable::fast_cos interface)
    // Range: -2π < x < 4π
    // Implementation: cos(x) = sin(x + π/2)
    FixedT fast_cos(const FixedT& x) const {
        // Same as fast_sin but with 256 offset (π/2 phase shift)
        constexpr double scale_float = TABLE_SIZE * TWOPI_RCP;  // ~162.97
        constexpr int64_t scale = static_cast<int64_t>(scale_float + 0.5);

        int64_t index_calc = (static_cast<int64_t>(x.raw()) * scale) >> FracBits;
        int32_t index = static_cast<int32_t>(index_calc);

        // Add π/2 offset (TABLE_SIZE / 4 = 256)
        index += 256;

        // Handle wraparound
        if (index >= static_cast<int32_t>(TABLE_SIZE)) {
            index -= TABLE_SIZE;
        } else if (index < 0) {
            index += TABLE_SIZE;
        }

        // Bounds check for safety
        if (index < 0 || index >= static_cast<int32_t>(TABLE_SIZE)) {
            index = 0;
        }

        return FixedT::from_raw(sine_lut[index]);
    }

    // ========================================================================
    // SOFTWARE LINEAR INTERPOLATION (Available on all platforms)
    // ========================================================================

    // Software sine with linear interpolation
    // Optimized for 32-bit arithmetic (minimizes 64-bit operations)
    // Provides 10-100x better accuracy than floor-based lookup
    // Named "_hw" for historical reasons, but uses pure software interpolation
    FixedT fast_sin_hw(const FixedT& x) const {
        constexpr double scale_float = TABLE_SIZE * TWOPI_RCP;
        constexpr int64_t scale = static_cast<int64_t>(scale_float + 0.5);

        // Calculate fractional index
        int64_t index_frac = (static_cast<int64_t>(x.raw()) * scale);

        // Extract index (use mask instead of conditional for wraparound)
        int32_t index = static_cast<int32_t>(index_frac >> FracBits);
        index = index & (TABLE_SIZE - 1);  // Fast modulo for power-of-2

        // Extract fractional part (16 bits)
        uint32_t frac = static_cast<uint32_t>(index_frac) & 0xFFFF;

        // Get table values
        uint32_t next_index = (index + 1) & (TABLE_SIZE - 1);
        int32_t val0 = sine_lut[index];
        int32_t val1 = sine_lut[next_index];

        // Optimized interpolation using 32-bit arithmetic
        // diff is at most ±2 (in Q16.16), so diff * frac fits in 32 bits
        int32_t diff = val1 - val0;

        // Use 32-bit multiply: (diff * frac) >> 16
        // This is much faster than 64-bit multiply on M0+
        int32_t interp = (diff * static_cast<int32_t>(frac)) >> 16;
        int32_t result = val0 + interp;

        return FixedT::from_raw(result);
    }

#ifdef PICO_SDK_VERSION_MAJOR
    // ========================================================================
    // HARDWARE INTERPOLATOR METHODS (RP2040 only)
    // ========================================================================

    // Hardware-accelerated sine using RP2040 interpolator for multiply
    // Uses hardware for the (diff * frac) >> 16 operation
    FixedT fast_sin_hw_accel(const FixedT& x) const {
        constexpr double scale_float = TABLE_SIZE * TWOPI_RCP;
        constexpr int64_t scale = static_cast<int64_t>(scale_float + 0.5);

        // Calculate fractional index
        int64_t index_frac = (static_cast<int64_t>(x.raw()) * scale);

        // Extract index
        int32_t index = static_cast<int32_t>(index_frac >> FracBits);
        index = index & (TABLE_SIZE - 1);

        // Extract fractional part
        uint32_t frac = static_cast<uint32_t>(index_frac) & 0xFFFF;

        // Get table values
        uint32_t next_index = (index + 1) & (TABLE_SIZE - 1);
        int32_t val0 = sine_lut[index];
        int32_t val1 = sine_lut[next_index];

        // Use hardware interpolator for multiply-shift
        int32_t diff = val1 - val0;

        // Hardware multiply with automatic shift
        // ACCUM = diff, BASE = frac, RESULT = (diff * frac) >> 16
        interp0->accum[0] = diff;
        interp0->base[0] = frac;
        int32_t delta = interp0->pop[0];  // Read result with shift applied

        return FixedT::from_raw(val0 + delta);
    }

    // Symmetry-optimized version using quarter-wave table
    // 4x smaller table (256 entries) with quadrant detection
    FixedT fast_sin_sym(const FixedT& x) const {
        constexpr double scale_float = TABLE_SIZE * TWOPI_RCP;
        constexpr int64_t scale = static_cast<int64_t>(scale_float + 0.5);

        // Calculate fractional index
        int64_t index_frac = (static_cast<int64_t>(x.raw()) * scale);

        // Extract index and quadrant
        int32_t full_index = static_cast<int32_t>(index_frac >> FracBits);
        int32_t quadrant = (full_index >> 8) & 0x3;  // Bits 8-9 = quadrant (0-3)
        int32_t index = full_index & 0xFF;           // Lower 8 bits = position in quadrant

        // Extract fractional part
        uint32_t frac = static_cast<uint32_t>(index_frac) & 0xFFFF;

        // Handle quadrant symmetry
        bool negate = false;
        if (quadrant == 1) {
            // Q1 [π/2, π]: use sin(π - x) = sin(x), so mirror index
            index = 255 - index;
        } else if (quadrant == 2) {
            // Q2 [π, 3π/2]: use sin(π + x) = -sin(x)
            negate = true;
        } else if (quadrant == 3) {
            // Q3 [3π/2, 2π]: use sin(2π - x) = -sin(x), mirror and negate
            index = 255 - index;
            negate = true;
        }

        // Get table values (only first 256 entries)
        uint32_t next_index = (index + 1) & 0xFF;
        if (next_index == 0) next_index = 0;  // Clamp at peak
        int32_t val0 = sine_lut[index];
        int32_t val1 = sine_lut[next_index];

        // Interpolate
        int32_t diff = val1 - val0;
        int32_t delta = (diff * static_cast<int32_t>(frac)) >> 16;
        int32_t result = val0 + delta;

        return FixedT::from_raw(negate ? -result : result);
    }

    // Cosine with linear interpolation (optimized)
    FixedT fast_cos_hw(const FixedT& x) const {
        constexpr double scale_float = TABLE_SIZE * TWOPI_RCP;
        constexpr int64_t scale = static_cast<int64_t>(scale_float + 0.5);

        int64_t index_frac = (static_cast<int64_t>(x.raw()) * scale);

        // Add π/2 offset (256 = TABLE_SIZE / 4) before masking
        int32_t index = static_cast<int32_t>(index_frac >> FracBits) + 256;
        index = index & (TABLE_SIZE - 1);

        // Extract fractional part
        uint32_t frac = static_cast<uint32_t>(index_frac) & 0xFFFF;

        // Get table values
        uint32_t next_index = (index + 1) & (TABLE_SIZE - 1);
        int32_t val0 = sine_lut[index];
        int32_t val1 = sine_lut[next_index];

        // Optimized 32-bit interpolation
        int32_t diff = val1 - val0;
        int32_t interp = (diff * static_cast<int32_t>(frac)) >> 16;
        int32_t result = val0 + interp;

        return FixedT::from_raw(result);
    }

    // Batch processing - process two sine values (optimized)
    void fast_sin_dual_hw(const FixedT& x0, const FixedT& x1,
                          FixedT& out0, FixedT& out1) const {
        constexpr double scale_float = TABLE_SIZE * TWOPI_RCP;
        constexpr int64_t scale = static_cast<int64_t>(scale_float + 0.5);

        // Process both values in parallel (optimized for cache locality)
        int64_t index_frac0 = (static_cast<int64_t>(x0.raw()) * scale);
        int64_t index_frac1 = (static_cast<int64_t>(x1.raw()) * scale);

        int32_t index0 = static_cast<int32_t>(index_frac0 >> FracBits) & (TABLE_SIZE - 1);
        int32_t index1 = static_cast<int32_t>(index_frac1 >> FracBits) & (TABLE_SIZE - 1);

        uint32_t frac0 = static_cast<uint32_t>(index_frac0) & 0xFFFF;
        uint32_t frac1 = static_cast<uint32_t>(index_frac1) & 0xFFFF;

        // Fetch all table values
        uint32_t next_index0 = (index0 + 1) & (TABLE_SIZE - 1);
        uint32_t next_index1 = (index1 + 1) & (TABLE_SIZE - 1);

        int32_t val0_0 = sine_lut[index0];
        int32_t val0_1 = sine_lut[next_index0];
        int32_t val1_0 = sine_lut[index1];
        int32_t val1_1 = sine_lut[next_index1];

        // Optimized 32-bit interpolation for both values
        int32_t diff0 = val0_1 - val0_0;
        int32_t diff1 = val1_1 - val1_0;

        int32_t delta0 = (diff0 * static_cast<int32_t>(frac0)) >> 16;
        int32_t delta1 = (diff1 * static_cast<int32_t>(frac1)) >> 16;

        out0 = FixedT::from_raw(val0_0 + delta0);
        out1 = FixedT::from_raw(val1_0 + delta1);
    }
#endif // PICO_SDK_VERSION_MAJOR

private:
    // Store raw values for memory efficiency
    // Using alignas(4) for optimal ARM Cortex-M0+ access
    alignas(4) std::array<StorageT, TABLE_SIZE> sine_lut;
};

// ============================================================================
// TYPE ALIASES FOR COMMON CONFIGURATIONS
// ============================================================================

using SineTableQ16_16 = SineTableFixed<16, 16, int32_t>;
using SineTableQ8_24 = SineTableFixed<8, 24, int32_t>;
using SineTableQ24_8 = SineTableFixed<24, 8, int32_t>;

} // namespace FixedPoint

#endif // SINETABLE_FIXED_HPP
