Emute-Lab-Instruments/Myriad/Myriad_A/sinetable.h

#pragma once 
const __not_in_flash("sinetable") std::array<float, 1024> sinetable1024 = {0.0, 0.006135884649154475, 0.012271538285719925, 0.01840672990580482, 0.024541228522912288, 0.030674803176636626, 0.03680722294135883, 0.04293825693494082, 0.049067674327418015, 0.055195244349689934, 0.06132073630220858, 0.06744391956366405, 0.07356456359966743, 0.07968243797143013, 0.0857973123444399, 0.09190895649713272, 0.0980171403295606, 0.10412163387205459, 0.11022220729388306, 0.11631863091190475, 0.1224106751992162, 0.12849811079379317, 0.13458070850712617, 0.1406582393328492, 0.14673047445536175, 0.15279718525844344, 0.15885814333386145, 0.16491312048996992, 0.17096188876030122, 0.17700422041214875, 0.18303988795514095, 0.1890686641498062, 0.19509032201612825, 0.2011046348420919, 0.20711137619221856, 0.21311031991609136, 0.2191012401568698, 0.22508391135979283, 0.2310581082806711, 0.2370236059943672, 0.24298017990326387, 0.24892760574572015, 0.25486565960451457, 0.2607941179152755, 0.26671275747489837, 0.272621355449949, 0.27851968938505306, 0.2844075372112719, 0.29028467725446233, 0.2961508882436238, 0.3020059493192281, 0.30784964004153487, 0.3136817403988915, 0.3195020308160157, 0.3253102921622629, 0.33110630575987643, 0.33688985339222005, 0.3426607173119944, 0.34841868024943456, 0.35416352542049034, 0.3598950365349881, 0.36561299780477385, 0.37131719395183754, 0.37700741021641826, 0.3826834323650898, 0.38834504669882625, 0.3939920400610481, 0.3996241998456468, 0.40524131400498986, 0.4108431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
5693494114, -0.036807222941359394, -0.030674803176636543, -0.024541228522912448, -0.018406729905805226, -0.012271538285720572, -0.006135884649154477};

/*
note - don't go beyond bounds of -2pi  < x < 4pi, assumes this range for efficiency
floor of index into lookup table to speed things up further.
fine for graphics!
*/
class sineTable {
public:
  static constexpr float twopircp = 1.0 / 6.283185307179586;

  static float fast_sin(float x) {
    size_t index = static_cast<size_t>(x * twopircp * 1024 );
    if (index >= 1024) {
      index -= 1024;
    }else if (index < 0) {
      index += 1024;
    }
    return sinetable1024[index];
  }

  static float fast_cos(float x) {
    size_t index = static_cast<size_t>(x * twopircp * 1024 );
    index += 256;
    if (index >= 1024) {
      index -= 1024;
    }else if (index < 0) {
      index += 1024;
    }
    return sinetable1024[index];
  }
};
