Emute-Lab-Instruments/Myriad/arduino_libmyriad/freqlookup.h

#ifndef FREQLOOKUP_H
#define FREQLOOKUP_H

//freq: 125000000/8

static const float __not_in_flash("freqtable") freqtable[] = 
{781250.0, 779929.0446839241, 778610.3228692205, 777293.8307794341, 775979.564644495, 774667.5207007083, 773357.6951907424, 772050.0843636186, 770744.684474701, 769441.4917856845, 768140.5025645854, 766841.71308573, 765545.1196297435, 764250.7184835408, 762958.5059403144, 761668.4782995244, 760380.631866888, 759094.9629543688, 757811.4678801659, 756530.142968704, 755250.9845506225, 753973.988962765, 752699.1525481687, 751426.4716560544, 750155.9426418155, 748887.5618670075, 747621.3256993387, 746357.230512658, 745095.2726869462, 743835.4486083046, 742577.7546689447, 741322.1872671788, 740068.7428074084, 738817.4177001149, 737568.2083618488, 736321.1112152195, 735076.1226888852, 733833.2392175427, 732592.457241917, 731353.7732087512, 730117.1835707963, 728882.6847868011, 727650.2733215023, 726419.9456456135, 725191.6982358162, 723965.5275747491, 722741.4301509979, 721519.402459086, 720299.4409994633, 719081.5422784971, 717865.7028084622, 716651.9191075298, 715440.1876997589, 714230.5051150852, 713022.867889312, 711817.2725640996, 710613.7156869565, 709412.1938112277, 708212.7034960865, 707015.2413065241, 705819.8038133394, 704626.3875931298, 703434.9892282805, 702245.6053069559, 701058.2324230889, 699872.8671763713, 698689.5061722447, 697508.1460218899, 696328.7833422178, 695151.4147558594, 693976.0368911561, 692802.6463821504, 691631.2398685762, 690461.8139958483, 689294.3654150544, 688128.8907829442, 686965.3867619201, 685803.8500200278, 684644.2772309472, 683486.6650739819,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

#endif
