Emute-Lab-Instruments/Myriad/arduino_libmyriad/oscmodels/expPulse2SDOscillatorModel.hpp

#pragma once
#include "oscillatorModel.hpp"

class expPulse2SDOscillatorModel : public virtual oscillatorModel {
  private:
    size_t loopLengthBits=0;
  public:


    expPulse2SDOscillatorModel() : oscillatorModel(){
      loopLength=16;
      prog=bitbybit_program;
      updateBufferInSyncWithDMA = true; //update buffer every time one is consumed by DMA
      setClockModShift(1);
    }

    Fixed<16,16> counterFP = Q16_16(0);
    Fixed<16,16> targetIncFP = Q16_16(1000);
    Fixed<16,16> targetIncFPOrg = Q16_16(1000);
    Fixed<16,16> targetFP= Q16_16(1000);
    Fixed<16,16> targIncMul = Q16_16(1.1f);
    Fixed<16,16> vinvStored = Q16_16(0.5f);

    // void recomputeTargetInc() {
    //   using fptype = Fixed<16,16>;
    //   static fptype oneSixteenth = fptype(1.f/16.f);
    //   static fptype three = fptype::from_int(3);
    //   fptype targmax = oneSixteenth.mulWith(WvlenFPType(this->wavelen));
    //   targetIncFPOrg = (vinvStored * targmax) + three;
    // }

    // void setWavelen(const size_t wlen) {
    //   oscillatorModel::setWavelen(wlen);
    //   // recomputeTargetInc();
    // }

    // Fixed<16,16> counterFPPhaseInc = Q16_16(1);
    // Fixed<16,16> counterFPPhaseIncInc = Q16_16(1.01f);
    // Fixed<16,16> counterFPPhaseIncIncPos = Q16_16(1.01f);
    // Fixed<16,16> counterFPPhaseIncIncNeg = Q16_16(0.99f);

    // Fixed<16,16> counterModFP = Q16_16(0);
    // Fixed<16,16> targetModFP= Q16_16(1000);
    // Fixed<16,16> targetModIncFPOrg= Q16_16(1000);
    // Fixed<16,16> targetModIncFP = Q16_16(1000);
    // Fixed<16,16> targModIncMul = Q16_16(1.1f);
    bool b1=0;
    // bool b2=0;

    inline void fillBuffer(uint32_t* bufferA) {
      const size_t wlen = this->wavelen;
      // const size_t modwlen = (Q16_16(wlen) * Q16_16(7.5f)).to_int(); // Modulator is much slower, creates pulse width modulation
      // const size_t modwlenhalf =modwlen >> 1;
      const Q16_16 onefp = Q16_16(1);
      const Q16_16 zerofp = Q16_16(0);

      static int32_t FADE_REF = 1 << 12;

      using fptype = Fixed<16,16>;
      static fptype oneSixteenth = fptype(1.f/16.f);
      static fptype three = fptype::from_int(3);
      // recompute the pulse-ramp seed from the live wavelen; it is only consumed
      // at the next phase==0 boundary, so this never disturbs the ramp mid-cycle
      fptype targmax = oneSixteenth.mulWith(WvlenFPType(wlen));
      targetIncFPOrg = (vinvStored * targmax) + three;

      const bool fading = fadeDirection != 0;
      const int32_t volumePeak = fading ? static_cast<int32_t>(
          (static_cast<int64_t>(FADE_REF) * fadeInvTable[fadeLevel]) >> 16
      ) : 0;
      int32_t lErr = err0;
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
