Emute-Lab-Instruments/Myriad/(commit log)

2024-10-05 encoders working
    [myriad panel.scad, myriad panel.stl, myriad.kicad_pcb, myriad.kicad_sch, spacers.scad, spacers.stl]
2024-10-06 spi comms for frequency etc
2024-10-11 saw and sqr
    [myriad panel.scad]
2024-10-11 i2c cx frequencies
2024-11-06 latest wtf chaos bitstreams
    [myriad_0.2.kicad_pcb, myriad_0.2.kicad_sch]
2024-11-08 pitch control on one osc, and fixed sluiggish fifo sm buffer
    [Myriad_A.ino, Myriad_B.ino, freqlookup.h, myriad_messages.h, smBitStreamOsc.h]
2024-11-15 finally approaching multiple pitch control
    [myriad_0.2.kicad_pcb, myriad_0.2.kicad_sch]
2024-11-18 sounding *(^&*(ing massive - pitch detune and octave on 6 oscs
2024-11-20 getting close to basics - oscModels and screen display of current model idxs
2024-12-06 checkpoint - crashes after four bank changes
    [Myriad_B.ino]
2024-12-07 6 oscs concurrent with model switching
2024-12-16 meta osc mode switching
    [myriad 0.2 panel.stl, myriad panel.scad, myriad_0.2.kicad_sch]
2024-12-27 panel and boundedenc class
    [myriad panel.scad, myriadPCBPanel.kicad_pcb, myriadPCBPanel.kicad_sch, myriad_0.2.kicad_pcb]
2025-01-07 ctrl() on 0.2 prop oscmodel
2025-01-21 better switch controls
2025-03-19 modulation targets
    [myriadPCBPanel_0.3.kicad_pcb, myriadPCBPanel_0.3.kicad_sch, myriadPCBPanel_0.3.step, myriad_0.3.kicad_pcb, myriad_0.3.kicad_sch]
2025-03-20 pitch+eps mods
2025-03-24 calibration screen and responsive filters on adc
2025-03-25 calibration limits
2025-03-25 slowed down ADC reads for better stability
    [oscillatorModels.hpp]
2025-04-08 separate LR outs
    [drive.kicad_sch, myriad_0.4.kicad_sch, untitled.kicad_sch]
2025-04-09 almost routed
    [drive.kicad_sch, myriad_0.4.kicad_sch, untitled.kicad_sch]
2025-04-11 v0.4 proto
    [drive.kicad_sch, myriad_0.4.kicad_sch]
2025-06-04 adc oversampling
    [myriadPanel0_4.kicad_pcb]
2025-06-05 hopefully fix filter crash
    [Myriad_A.ino]
2025-06-06 tidy up
    [drive.kicad_sch, myriad_0.4.kicad_sch, untitled.kicad_sch]
2025-06-13 fixed osc model switching issue. Full variable PW saw wave model.
    [Myriad_A.ino, bitstreams.hpp, clockfreq.h, oscillatorModels.hpp, smBitStreamOsc.h]
2025-06-29 branchless ops on delta-sigma saw core
    [myriad_0.3.kicad_pcb]
2025-07-23 sorted switch glitch in myriad A
    [Myriad_A.ino, bitstreams.hpp, oscillatorModels.hpp, smBitStreamOsc.h]
2025-07-23 switch glitch
2025-07-25 calibration screen showing encoders and firmware version
2025-07-25 calibration saved, also cleared out some old display code
2025-07-28 two more SD oscillator models added
    [oscexpts.hpp, oscillatorModels.hpp]
2025-08-26 encoder acceleration in metamod mode, closes #2
2025-08-27 fixed walkers graphics, fixed sines uninit array, closes #35
    [displayPortal.h, drawing.h, metaOscs.hpp, oscillatorModels.hpp]
2025-08-29 move display callback out of timer
2025-08-29 moved part of adc processor out of the timer
2025-08-31 better debounce, wait to read encoder after switch up, don't read while switch down, display mode switch concurrency error. closes #23, #42, #43
    [Myriad_A.ino, debouncer.hpp, displayPortal.h, metaOscs.hpp]
2025-08-31 fixed font update on osc model index
    [Myriad_A.ino, displayPortal.h]
2025-09-03 scratch mem bank for dma irq
2025-09-19 adc parameters
2025-09-19 refactor(adc): replace DMA ADC capture with interrupt-driven smoothing
    - Removed DMA-based ADC data capture and replaced with interrupt-driven ADC capture.
    - Added IIR smoothing for ADC knob inputs to improve signal stability.
    - Reduced capture buffer size for compatibility.
    - Updated ADC initialization to use round-robin sampling and interrupt handler setup.
    - Adjusted frequency setting code to use smoothed knob values instead of raw capture buffer.
    - Updated CMakeLists.txt to reflect hardware_adc library usage changes.
    This refactor improves ADC input handling by using interrupts and smoothing, removing the complexity of DMA setup.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
2025-09-20 adc stuff
2025-09-20 chained dma adc reading
2025-09-20 adc timing
2025-09-21 adc limits
2025-09-21 fixed some glitches - scratch mem for osc buffers
    [Myriad_A.ino, Myriad_B.ino]
2025-09-22 upgraded bank switching, and lowered latency on sqosc2
2025-09-23 small optimisations to bank switching and boot up
2025-09-23 adc ranges
2025-09-23 move to 9 point calibration
2025-09-24 saving calibration
2025-11-26 stable bank switching on B
2025-11-26 dma and bank change on A
2025-11-26 removed unnecessary TX interrupt
2025-11-26 wait for dma before sending
2025-11-26 controlvalues -> size_t avoids lots of float conversions
    [Myriad_A.ino, fixedlpf.hpp, metaOscs.hpp]
2025-11-28 octave shift -> fixed
    [Myriad_A.ino, calibration.hpp, fastExpFixed.hpp, fixedlpf.hpp, fixedpoint.hpp, octaves.hpp, tuning.hpp, utils.hpp]
2025-12-01 start of meta fixed conversion
    [fixedpoint.hpp, metaOscSinesFMultipleFixed.hpp, metaOscSinesFixed.hpp, sinetable_fixed.hpp]
2025-12-02 rewire for mod processing fixed
    [Myriad_A.ino, displayPortal.h, drawing.h, metaOscs.hpp, oscillatorModels.hpp, smBitStreamOsc.h, state.hpp, utils.hpp]
2025-12-03 failed plan to use variants
    [Myriad_A.ino, Myriad_B.ino, metaOscs.hpp]
2025-12-07 move adc to core 1
2025-12-09 closes #62, full reset of metamods after mode or target change
    [Myriad_A.ino, Myriad_B.ino]
2025-12-19 new osc models, pitch correction
    [octave table.ods]
2025-12-22 adc calibration and pitch calculations
    [drive.kicad_sch, myriad_0.5.kicad_sch, untitled.kicad_sch]
2026-01-14 self calibration mappings
2026-01-30 closes #79 remove serial prints
2026-01-30 closes #80 adc correction to all inputs
    [Myriad_A.ino]
2026-01-30 fixes #82 oct to model mappings
    [Myriad_A.ino, Myriad_B.ino]
2026-02-02 fixes #81 osc animation glitch
    [Myriad_A.ino]
2026-02-04 overflow fix to tri model
    [oscillatorModels.hpp]
2026-02-04 noise osc conversion to SD, closes #91
    [Myriad_A.ino, fixedpoint.hpp, oscexpts.hpp, oscillatorModels.hpp]
2026-02-04 buffer size too low for saw
    [Myriad_A.ino, oscexpts.hpp, oscillatorModels.hpp]
2026-02-05 fixes #95 sine osc optimisation
    [oscillatorModels.hpp]
2026-03-15 bank switch fades - inroads
2026-03-19 removed jumper in cv3 input path
    [myriad_0.5.kicad_sch]
2026-03-19 removed jumper connection from filter out left channel to CV3
    [myriad_0.5.kicad_sch]
2026-03-19 pcb update reconnect CV3
2026-03-20 fixed ringing in noisemodel
    [noiseOscillatorModelSD.hpp]
2026-04-20 bell osc hf noise
    [Myriad_A.ino, bellSDOscillatorModel.hpp]
2026-05-30 wavelen resets on exppulse models
    [expPulse2SDOscillatorModel.hpp, expPulseSDOscillatorModel.hpp, whiteNoiseOscillatorModel.hpp]
2026-06-30 2026 Panel run
    AI and posin dxf files
    [myriad-all_layers-filled-cnc.dwg, myriad-all_layers-filled-cnc.dxf, myriad-all_layers-filled-pink.dxf, myriad-all_layers-filled-white.dxf, myriad-all_layers.dwg]
